wagiminator/ATtiny814-USB-RTC/documentation/USB-RTC_pic4.jpg

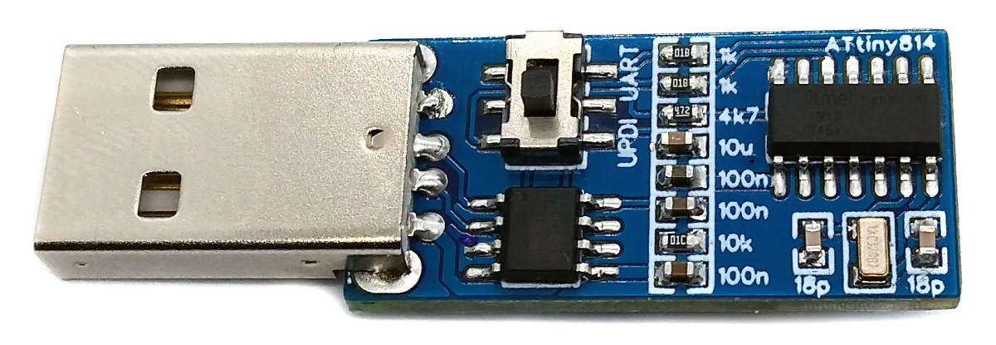
documentation/USB-RTC_pic4.jpg
