wagiminator/ATtiny814-USB-RTC/documentation/USB-RTC_pic5.jpg

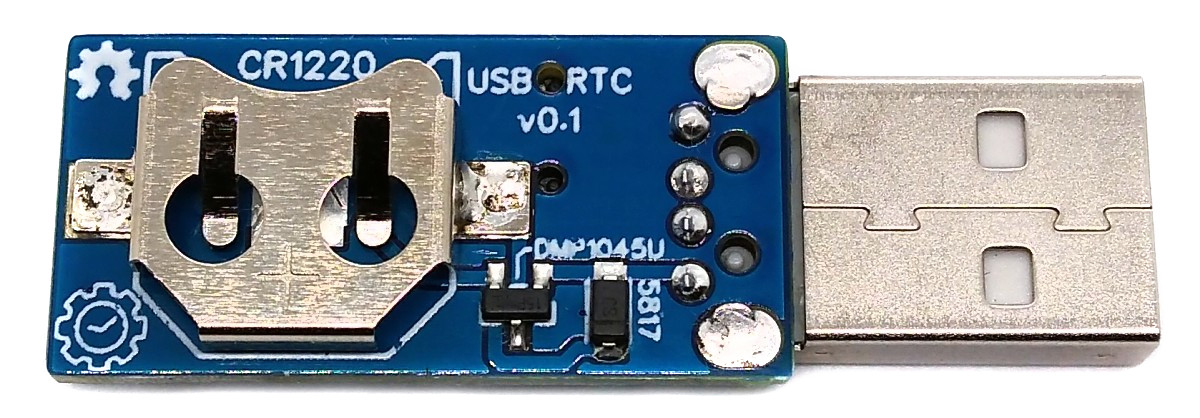
documentation/USB-RTC_pic5.jpg
