wagiminator/ATtiny814-USB-RTC/hardware/USB-RTC_BOM.tsv

ID | Name | Designator | Footprint | Quantity | Manufacturer Part | Manufacturer | Supplier | Supplier Part
1 | CR1220 | B1 | CR1220-SMD | 1 | MY-1220-03 | MYOUNG | LCSC | C964818
2 | 100n | C1,C5,C6 | C_0603 | 3 | CC0603KRX7R9BB104 | YAGEO | LCSC | C14663
3 | 10u | C2 | C_0603 | 1 | CL10A106MA8NRNC | SAMSUNG | LCSC | C96446
4 | 18p | C3,C4 | C_0603 | 2 | CL10C180JB8NNNC | SAMSUNG | LCSC | C1647
5 | 5817 | D1 | SCHOTTKY-SOD-123 | 1 | 1N5817W |  | LCSC | C727113
6 | DMP1045U-7 | Q1 | SOT-23-3_W | 1 | DMP1045U-7 | Diodes Incorporated | LCSC | C177033
7 | 1k | R1 | 0603 | 1 | 0603WAF1001T5E | UniOhm | LCSC | C21190
8 | 10k | R2 | 0603 | 1 | 0603WAF1002T5E | UniOhm | LCSC | C25804
9 | K3-2380S-E1 | SW1 | SW-SMD_K3-2380S-E1 | 1 | K3-2380S-E1 | Rectangular Connectors - Contacts | LCSC | C145837
10 | ATTINY814-SSN | U1 | SOIC-14_150MIL | 1 | ATTINY814-SSNR | Microchip Tech | LCSC | C182202
11 | CH340N | U2 | SOP-8_150MIL | 1 | CH340N | WCH(Jiangsu Qin Heng) | LCSC | C506813
12 | USB-Plug | USB1 | USB-M-48-2 | 1 | USB-05 | SOFNG | LCSC | C112454
13 | 32.768KHz | X1 | OSC-SMD_3215 | 1 | AH03270014 | TXC Corp | LCSC | C409356
