wagiminator/ATtiny814-USB-RTC/hardware/USB-RTC_schematic.pdf

# GNDB⁺

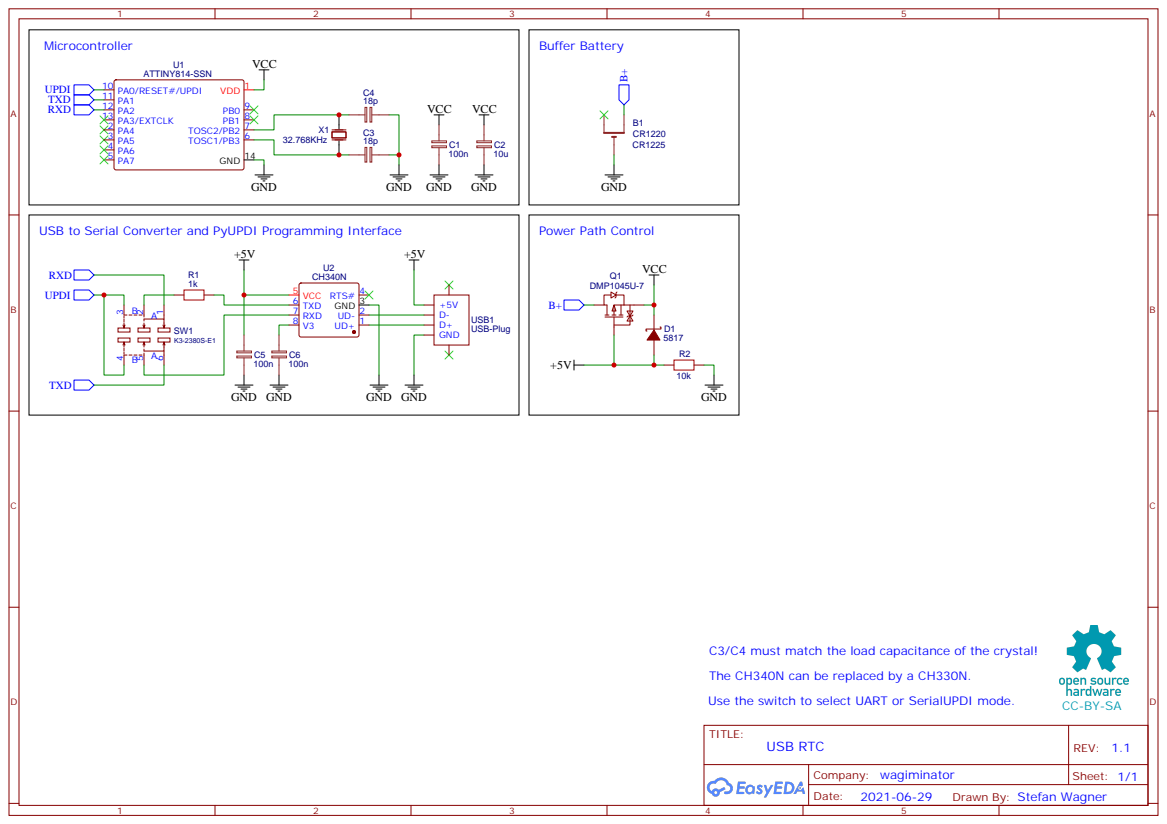
[picture p9: page 1]

USB to Serial Converter and PyUPDI Programming Interface

C3/C4 must match the load capacitance of the crystal!
The CH340N can be replaced by a CH330N.
Use the switch to select UART or SerialUPDI mode.

Drawn By: Stefan Wagner
